akshatsri121/UrjaGrid-Monitor/STL Files/box.stl

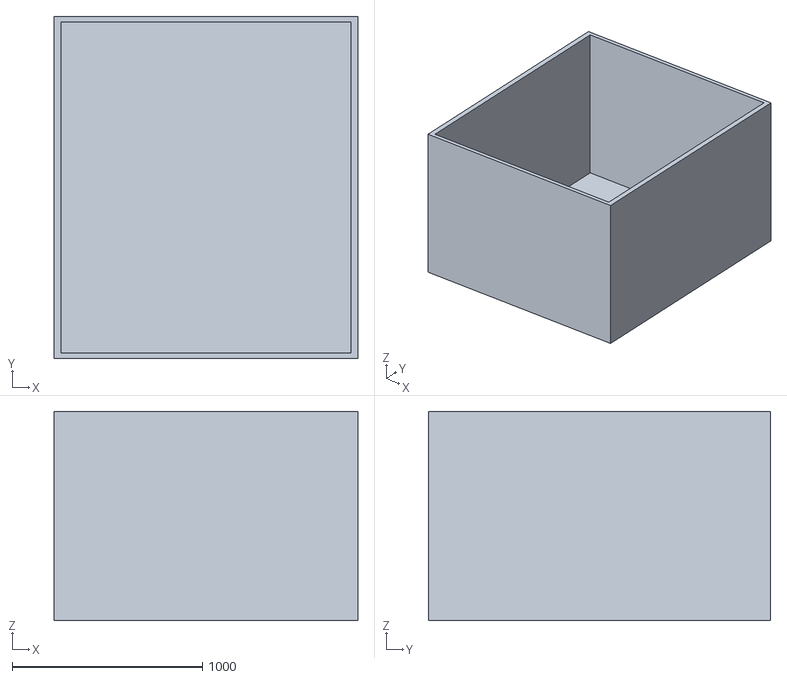
[picture p11: CAD file, 2026-10-27]
STL Files/box.stl
1600.0 x 1800.0 x 1100.0
