akshatsri121/UrjaGrid-Monitor/STL Files/slant 1.stl

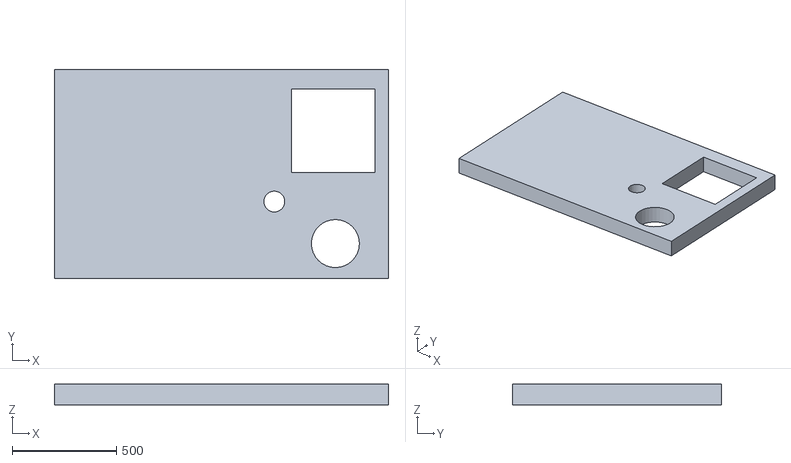
[picture p12: CAD file, 2026-10-27]
STL Files/slant 1.stl
1600.0 x 1000.0 x 100.0
