akshatsri121/UrjaGrid-Monitor/STL Files/slant 22.stl

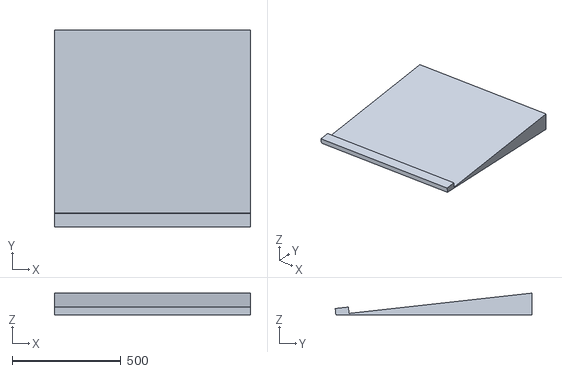
[picture p13: CAD file, 2026-10-27]
STL Files/slant 22.stl
900.0 x 903.3 x 100.0
