akshatsri121/UrjaGrid-Monitor/firmware/Smart_Microgrid_ESP32_One_INA219/secrets.example.h

// Copy to secrets.h and enter your credentials. Do not commit secrets.h.
#pragma once
#define BLYNK_AUTH_TOKEN "YOUR_BLYNK_AUTH_TOKEN"
#define WIFI_SSID "YOUR_WIFI_NAME"
#define WIFI_PASSWORD "YOUR_WIFI_PASSWORD"
