akshatsri121/UrjaGrid-Monitor/(commit log)

2026-10-23 Add acknowledged Automatic and Manual battery protection modes
2026-10-23 Separate INA219 measurement validity from battery source validation
2026-10-27 Add final report, poster, enclosure models and legacy prototype
